AneekMubarak/MobileToolAssistant/readme.md

# Mobile Tool Assistant

MobileToolAssistant is a capstone project to design and build a mobile robotic assistant that can autonomously follow a worker, carry tools, and reduce physical strain in demanding work environments such as construction or industrial sites.

## Team Members
* Aneek Mohamed Ruksan
* Aditya Ramakrishnan
* Ethan D'Almeida
* Chidubem Emeka-Nwuba
