AneekMubarak/MobileToolAssistant/docs/g5_assign4_project_plan.pdf

DEPARTMENT OF ELECTRICAL AND COMPUTER ENGINEERING UNIVERSITY OF SASKATCHEWAN
ECE495-2025G504 | VERSION 0.1 | PROJECT PLAN

© Chidubem Emeka-Nwuba, Aneek Mohammed Ruksan, Aditya Ramakrishnan, Ethan D'Almeida

This document is CONFIDENTIAL and PROPRIETARY and is for the use of University of Saskatchewan personnel only, except to the extent that permission is expressly granted elsewhere.

In any event, no part of this document may be reproduced in any form without the express written consent of University of Saskatchewan.

UNIVERSITY OF SASKATCHEWAN. PROPRIETARY AND CONDIDENTIAL | Page 1 of 9
DOC NO: | ECE495-2025G504 | ISSUE DATE: | 06-11-2025
FILE NAME: | g5_assign4_project_plan.pdf | VERSION NO: | 0.1
FILING PATH: | https://github.com/AneekMubarak/MobileToolAssistant/blob/main/docs/
TITLE: | PROJECT PLAN
PROJECT: | MOBILE TOOL ASSISTANT
KEYWORDS: | Planning, Mobile Tool Assistant, Project Management, Tasks, Deadline

© Chidubem Emeka-Nwuba, Aneek Mohammed Ruksan, Aditya Ramakrishnan, Ethan D'Almeida

This document is CONFIDENTIAL and PROPRIETARY and is for the use of University of Saskatchewan personnel only, except to the extent that permission is expressly granted elsewhere.

UNIVERSITY OF SASKATCHEWAN. PROPRIETARY AND CONDIDENTIAL | Page 2 of 9

APPROVED BY

Daniel Teng | Date
Customer

PREPARED BY:

Aditya Ramakrishnan | Date
Design Engineer
Aneek Mohammed Ruksan | Date
Design Engineer
Chidubem Emeka-Nwuba | Date
Design Engineer
Ethan D’Almeida | Date
Design Engineer

REVIEWED BY:

Chandler Janzen | Date
Supervisor

© Chidubem Emeka-Nwuba, Aneek Mohammed Ruksan, Aditya Ramakrishnan, Ethan D'Almeida

This document is CONFIDENTIAL and PROPRIETARY and is for the use of University of Saskatchewan personnel only, except to the extent that permission is expressly granted elsewhere.

UNIVERSITY OF SASKATCHEWAN. PROPRIETARY AND CONDIDENTIAL | Page 3 of 9

REVISION HISTORY
Version No. | Date | Originator | Summary of Changes
1 | 03-11-2025 | C.D.N, A.R, A.M.R, E.D | Document created

© Chidubem Emeka-Nwuba, Aneek Mohammed Ruksan, Aditya Ramakrishnan, Ethan D'Almeida

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

UNIVERSITY OF SASKATCHEWAN. PROPRIETARY AND CONDIDENTIAL | Page 4 of 9

## Table of Contents

Task List | 5
Effort Histogram Chart | 6
Cumulative Effort Chart | 6
Material Budget | 7
Appendix | 8

## List of Tables

Table 1: Task List | 5
Table 2: Material Budget | 7
Table 3: Risk Assessment | 8

## List of Figures

Figure 1: Effort Histogram | 6
Figure 2: Cumulative Effort Chart | 6
Figure 3: Milestone Schedule Chart | 8

## Task List

Table 1: Task List
Task ID | Task Name | Estimated Hours | Responsible Member | Precedence | Deadline
1 | Detailed Design (Assignment) | 20h | Chidubem | None | 27th Nov ,2025.
2 | Parts Selection and Ordering | 10h | Aditya | T1 | 1 st Dec ,2025.
3 UWB Tracking Module (User | Tracking) | 40h | Aneek | T2 | 21st Jan, 2026.
4 | Obstacle Detection | 45h | Chidubem | T2 | 21st Jan, 2026.
5 Motion Control Algorithm (Motor | wiring) | 21h | Ethan | T3, T4 | 30th Jan, 2026
6 User Interface (and User Node | Assembly) | 20h | Aneek | T3 | 30th Jan, 2026
7 | Power Management System | 24h | Aditya | T1 | 21st Jan, 2026
8 System Assembly and Integration | (Constructing Prototype) | 30h | Chidubem | T5, T6, T7 | 15th Feb, 2026
9 Chassis Design and | Printing/Ordering | 15h | Aditya | T8 | 15th Feb, 2026
10 | System Testing and Debugging | 37h | Ethan | T9 | 28th Feb, 2026
11 System Refining and | Performance Improvement | 16h | Aneek | T10 | 28th Feb, 2026

## Effort Histogram Chart

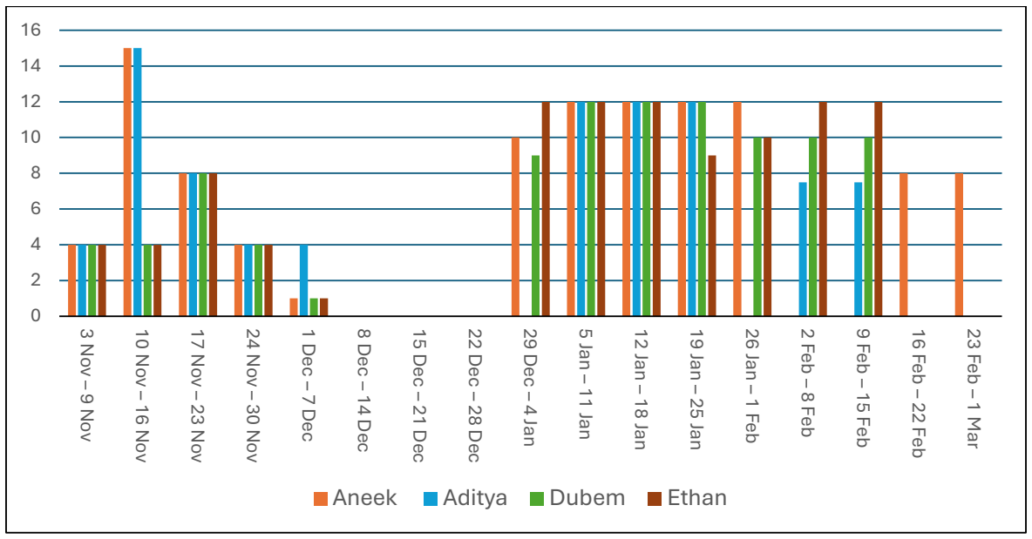
[picture p14: figure]
3 Nov – 9 Nov; 10 Nov – 16 Nov; 17 Nov – 23 Nov; 24 Nov – 30 Nov; 1 Dec – 7 Dec; 8 Dec – 14 Dec; 15 Dec – 21 Dec; 22 Dec – 28 Dec; 29 Dec – 4 Jan; 5 Jan – 11 Jan; 12 Jan – 18 Jan; 19 Jan – 25 Jan; 26 Jan – 1 Feb; 2 Feb – 8 Feb; 9 Feb – 15 Feb; 16 Feb – 22 Feb; 23 Feb – 1 Mar; Aneek; Aditya; Dubem; Ethan

Figure 1: Effort Histogram

## Cumulative Effort Chart

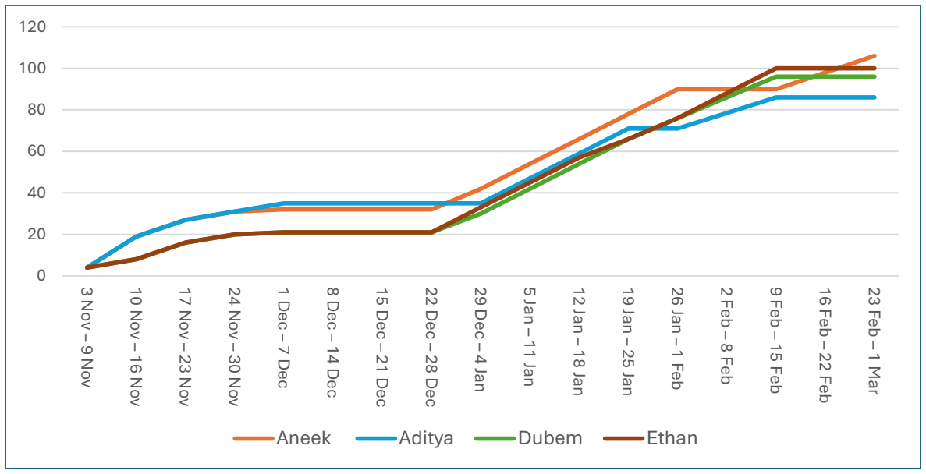
[picture p15: figure]
3 Nov – 9 Nov; 10 Nov – 16 Nov; 17 Nov – 23 Nov; 24 Nov – 30 Nov; 1 Dec – 7 Dec; 8 Dec – 14 Dec; 15 Dec – 21 Dec; 22 Dec – 28 Dec; 29 Dec – 4 Jan; 5 Jan – 11 Jan; 12 Jan – 18 Jan; 19 Jan – 25 Jan; 26 Jan – 1 Feb; 2 Feb – 8 Feb; 9 Feb – 15 Feb; 16 Feb – 22 Feb; 23 Feb – 1 Mar; Aneek; Aditya; Dubem; Ethan

Figure 2: Cumulative Effort Chart

## Material Budget

Table 2: Material Budget
Item | Quantity | Estimated Cost | Needed by
UWB Transceiver modules | 3 | 135$ | Dec 10
Processing board | 1 | 80$ | Dec 10
Ultrasonic sensor | 4 | 25$ | Dec 10
Motor Driver | 4 | 50$ | Dec 15
Rechargeable Battery Pack | 1 | 45$ | Dec 18
PLA filament | 2 kg | 40$ | Jan 13
Wiring / Misc electronics | - | 20$ | Dec 10

## Appendix

(i) Milestone Schedule

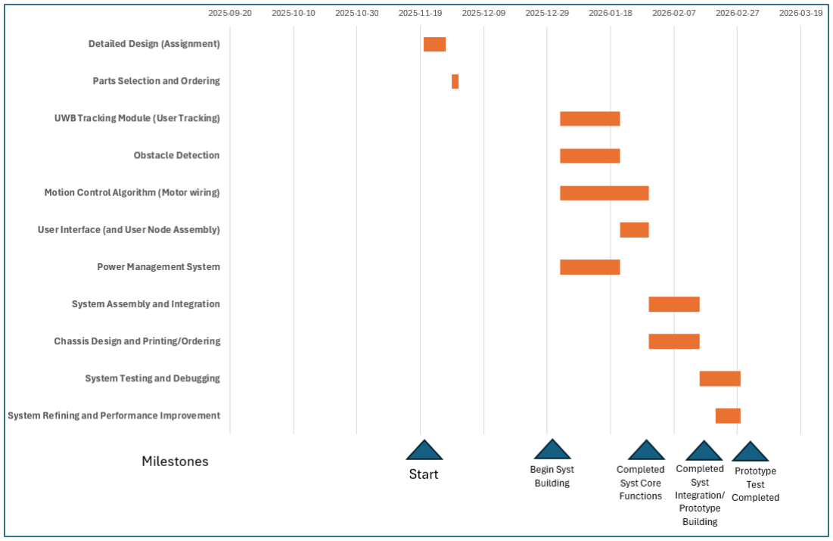
[picture p16: figure]

Figure 3: Milestone Schedule Chart

(ii) Risk Assessment

Table 3: Risk Assessment
Risk | Probability | Impact | Mitigation Strategy
Component Delivery Delays | Medium | High | Identify critical components early, and order them in advance
Software Issues | High | High | Use version control, review code with the team
Defective Components | Low | High | Buy in surplus quantities and test all parts on arrival. Make sure to buy

| | | from reputable vendors.
Team Member Availability | Medium | Medium | Team members should be informed what other members are working on, in case a member is unavailable to work on a task.
System Integration Issues | High | High | Have lots of time for testing, maintain detailed documentation
Schedule Overruns | Medium | Medium | Prioritize critical tasks, and discuss team progress weekly
Mechanical Issues | Low | High | Inspect components, use durable materials
