AneekMubarak/MobileToolAssistant/Case.stl

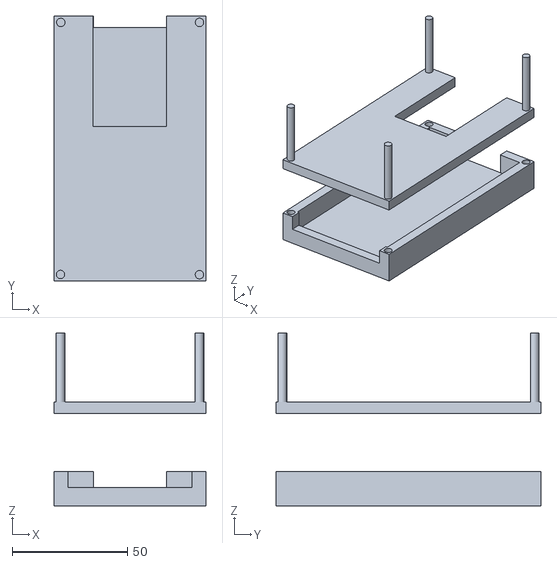
[picture p17: CAD file, 2026-04-08]
Case.stl
65.8 x 115.0 x 75.0
