AneekMubarak/MobileToolAssistant/Chassis.stl

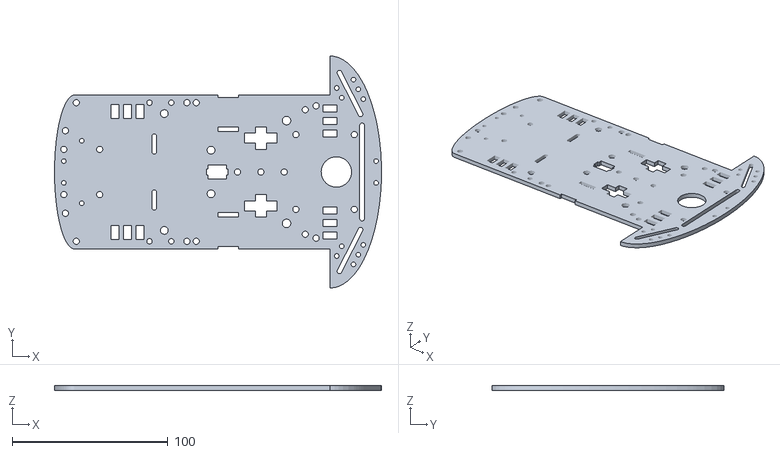
[picture p18: CAD file, 2026-04-08]
Chassis.stl
210.0 x 149.0 x 3.00
