AneekMubarak/MobileToolAssistant/RobotArmStart v1.stl

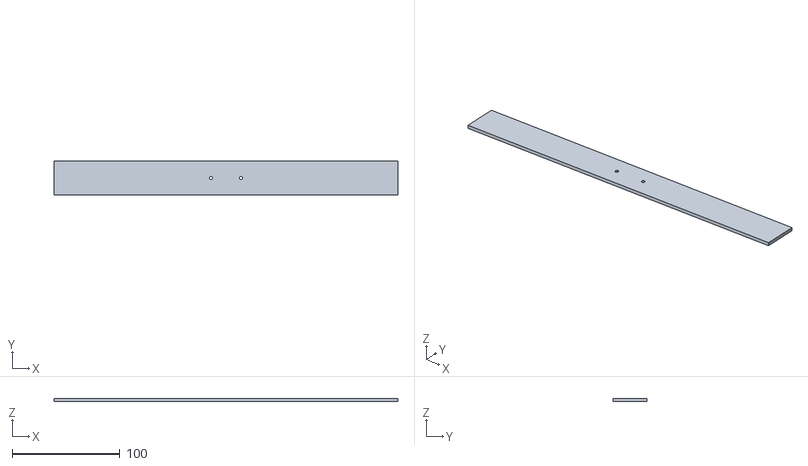
[picture p19: CAD file, 2026-04-08]
RobotArmStart v1.stl
320.0 x 32.0 x 3.00
