AneekMubarak/MobileToolAssistant/DWM1000_tests/esp82/wiring.txt

VCC 3.3v extern

Sclk D5
MOSI d7
MISO d6
CS d8
RESETn D4
