AneekMubarak/MobileToolAssistant/(commit log)

2026-02-10 Added SPI test program for STM32 *Reads the device ID from the DW1000 to verify SPI
2026-02-17 Port DW1000 code into RTOS project - Created driver for handling multiple tranceivers - Create basic SPI register read/write fxns and verify by reading deviceID.
2026-02-17 Port DW1000 driver to RTOS project with basic tx support
    - implemented sub-register read/write
    - added default configuration routine according to datasheet
    - implemented basic transmit function
    - performed theoretical tx testing
2026-02-18 Added driver for ToF sensor - Modified platform.c to acccomadote STM32F407G i2c configs - Added a ToF task to test sensor
2026-02-19 Got spi to work on ESP82
2026-02-19 Remove non-working esp82 spi files
2026-02-19 Get transmit to work on esp82 Created driver for DW1000 for esp with basic read/write register and transmit functions Added dynamic SPI clock speed to be (3MHz during init and 20Mhz afterwards)
2026-02-25 Implement basic ToF ranging(distance calculation inaccurate)
    - Single-sided TWR implemented and functional.
    - Timestamps and reply delay exchange working.
    - Distance calculation still incorrect and requires calibration/debugging.
2026-03-02 Re-implement Single Sided TWR with state machine and basic error handling
    [main.c, main.ino]
2026-03-03 Implemented Double sided two way ranging with transmitter and receiver set to default configurations. TODO: Antenna delay callibration
2026-04-07 Added docstring/comments for DWM1000 Driver and Triangulation files
2026-04-08 Added 3d Models
    [Case.stl, Chassis.stl, RobotArmStart v1.stl]
